Shaoting-Feng/Ultrasonic-Measuring-Distance/README.md

# Ultrasonic Measuring Distance

This project involves designing and manufacturing an ultrasonic application circuit to measure distance and display the measured distance on a digital tube.

## Table of Contents
- [Introduction](#introduction)
- [Requirements](#requirements)
- [Installation](#installation)
- [Usage](#usage)
- [License](#license)

## Introduction
This experiment requires the design and manufacture of an ultrasonic application circuit to realize ultrasonic ranging and display the measured distance on a digital tube.

## Requirements
- Verilog
- CAD software for circuit design
- Digital tube display

## Installation
1. Clone the repository:
   ```bash
   git clone https://github.com/Shaoting-Feng/Ultrasonic-Measuring-Distance.git
   ```
2. Navigate to the project directory:
   ```bash
   cd Ultrasonic-Measuring-Distance
   ```

## Usage
1. Design the circuit using the provided CAD files.
2. Implement the ultrasonic ranging application using Verilog.
3. Display the measured distance on the digital tube.

## License
This project is licensed under the MIT License. See the [LICENSE](LICENSE) file for details.
