Shaoting-Feng/Ultrasonic-Measuring-Distance/Pin Constraints.txt

set_property PACKAGE_PIN B4 [get_ports {a_to_g[6]}]
set_property PACKAGE_PIN A4 [get_ports {a_to_g[5]}]
set_property PACKAGE_PIN A3 [get_ports {a_to_g[4]}]
set_property PACKAGE_PIN B1 [get_ports {a_to_g[3]}]
set_property PACKAGE_PIN A1 [get_ports {a_to_g[2]}]
set_property PACKAGE_PIN B3 [get_ports {a_to_g[1]}]
set_property PACKAGE_PIN B2 [get_ports {a_to_g[0]}]
set_property PACKAGE_PIN D5 [get_ports dot]
set_property PACKAGE_PIN D15 [get_ports signal_1]
set_property PACKAGE_PIN E15 [get_ports signal_2]
set_property PACKAGE_PIN R15 [get_ports start]
set_property IOSTANDARD LVCMOS33 [get_ports {a_to_g[6]}]
set_property IOSTANDARD LVCMOS33 [get_ports {a_to_g[5]}]
set_property IOSTANDARD LVCMOS33 [get_ports {a_to_g[4]}]
set_property IOSTANDARD LVCMOS33 [get_ports {a_to_g[3]}]
set_property IOSTANDARD LVCMOS33 [get_ports {a_to_g[2]}]
set_property IOSTANDARD LVCMOS33 [get_ports {a_to_g[1]}]
set_property IOSTANDARD LVCMOS33 [get_ports {a_to_g[0]}]
set_property PACKAGE_PIN G2 [get_ports {led_bits[3]}]
set_property PACKAGE_PIN C2 [get_ports {led_bits[2]}]
set_property PACKAGE_PIN C1 [get_ports {led_bits[1]}]
set_property PACKAGE_PIN H1 [get_ports {led_bits[0]}]
set_property IOSTANDARD LVCMOS33 [get_ports {led_bits[3]}]
set_property IOSTANDARD LVCMOS33 [get_ports {led_bits[2]}]
set_property IOSTANDARD LVCMOS33 [get_ports {led_bits[1]}]
set_property IOSTANDARD LVCMOS33 [get_ports {led_bits[0]}]
set_property PACKAGE_PIN P17 [get_ports clk]
set_property PACKAGE_PIN E17 [get_ports receive]
set_property PACKAGE_PIN K2 [get_ports start_detect]
set_property PACKAGE_PIN J2 [get_ports receive_detect]
set_property PACKAGE_PIN J3 [get_ports flag_square_detect]
set_property PACKAGE_PIN H4 [get_ports flag_button_detect]
set_property IOSTANDARD LVCMOS33 [get_ports clk]
set_property IOSTANDARD LVCMOS33 [get_ports dot]
set_property IOSTANDARD LVCMOS33 [get_ports flag_button_detect]
set_property IOSTANDARD LVCMOS33 [get_ports flag_square_detect]
set_property IOSTANDARD LVCMOS33 [get_ports receive]
set_property IOSTANDARD LVCMOS33 [get_ports receive_detect]
set_property IOSTANDARD LVCMOS33 [get_ports signal_1]
set_property IOSTANDARD LVCMOS33 [get_ports signal_2]
set_property IOSTANDARD LVCMOS33 [get_ports start]
set_property IOSTANDARD LVCMOS33 [get_ports start_detect]
create_clock -period 10.000 -name clk -waveform {0.000 5.000}
