Shaoting-Feng/Ultrasonic-Measuring-Distance/(list of files, drawings)

Other design files:
CAD for the Entire Circuit.ms14
